Motion-Controller/prj_UPA_minimal/doc/Arduino-Pro-schematic.docx

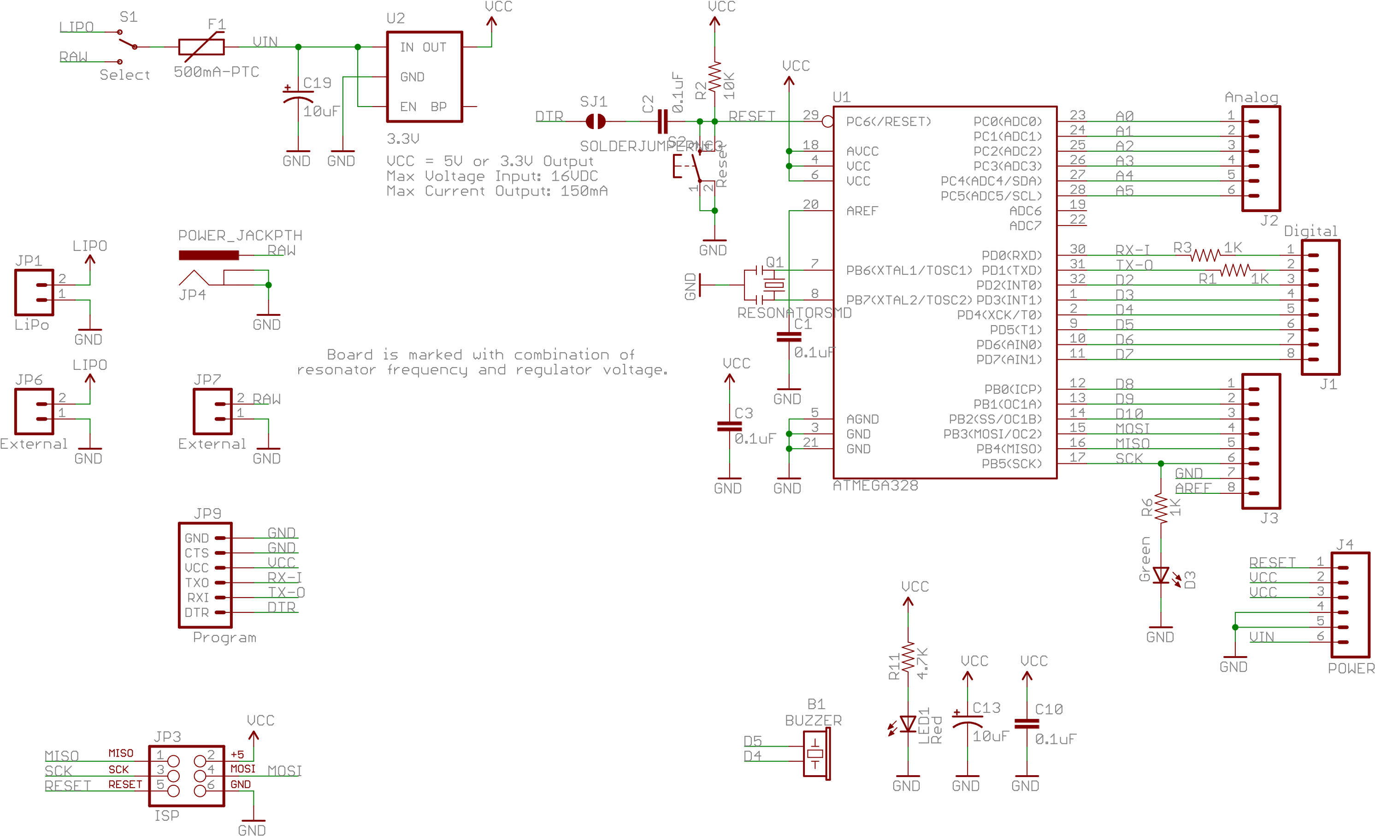
[picture p22: figure]
