Motion-Controller/prj_UPA_minimal/doc/20.JPG

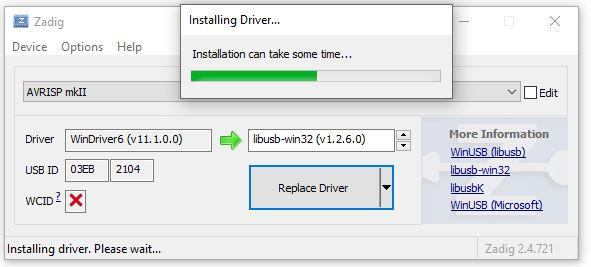
doc/20.JPG
