Motion-Controller/prj_UPA_minimal/doc/21B.JPG

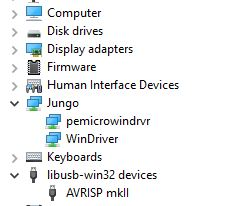
doc/21B.JPG
