Motion-Controller/prj_UPA_minimal/(commit log)

2020-05-07 all dependencies are included in the PROJECT FOLDER, added todo.txt, compiled OK for Parallel LCD for Arduino NANO and PRO
2020-05-11 build for Arduino Nano, programmed succesfully with Arduino-ISP
2020-05-22 schematic and perforated board in progress
2020-05-24 iteration-3 PCB routed
2020-05-25 added LCD-assembly 3d modeling
2020-05-25 new build.cmd builds with arduino-cli,
2020-05-25 describe in READ.ME how to install and build with arduino-cli
2020-05-25 todo.txt update, and better story on arduino-ide
2020-05-26 integration with 3D printer photos
2020-05-31 xREADME.MD Add photo from arduino programming boards setup and Document AVR MKII upload from command-line
2021-06-17 win device manager
2021-06-17 Display works with designed pcb
2021-06-17 device manager detail
2021-06-17 tested incremental encoder
2021-06-17 bourns encoder image
